RealEstate2/MiniPos/MiniPos GS.pdf

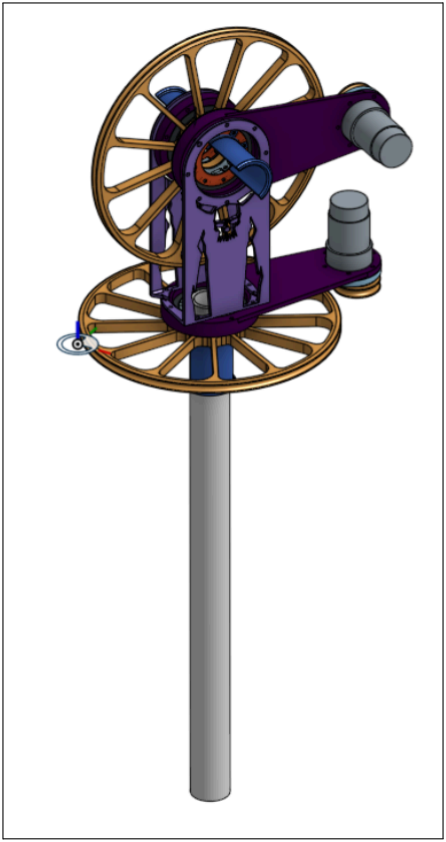
[picture p1: figure]

MiniPos Belt Driven Az-El Rotator with [6.667:1 = 20:3] Gear Ratio

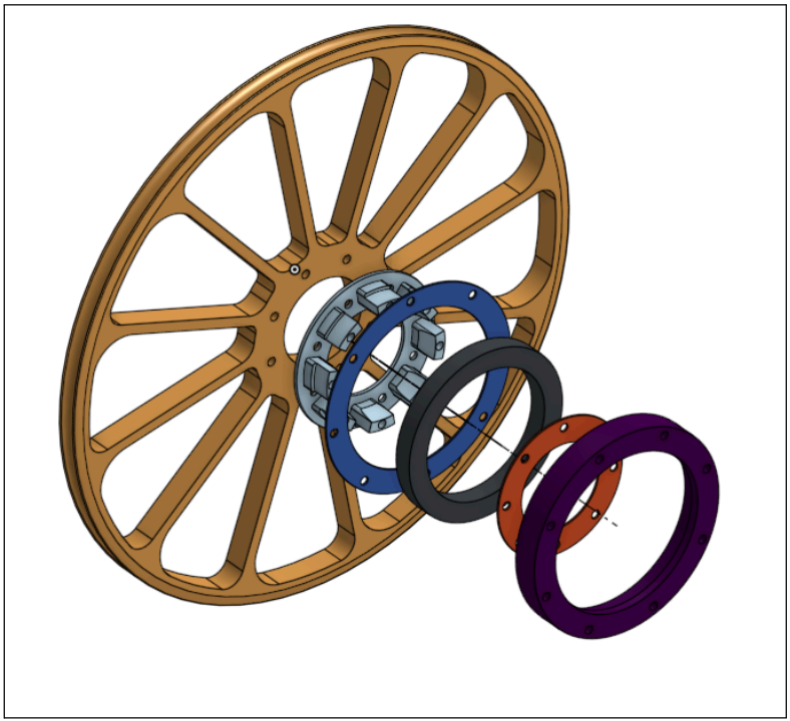
[picture p2: figure]

Bearing Assembly Part Order is as Such (Right To Left) Part Name: [8” Pulley Wheel - Bearing Hub -Bearing Retainer L - Bearing - Bearing Retainer S -Bearing Collar ]
Part #:[2- 8 - 11 - 7 - 10 - 9]

BOM

Part # | Name | Section | Quantity | Procurment | Cost ($) | 3D Print Mass (g)
1 | 1.2" Pully Wheel | Pully Drive | 2 | FDM | - | 5
2 | 8" Pully Wheel | Pully Drive | 2 | FDM | - | 78
3 | Polyeurethane Belt | Pully Drive | 2 | Amazon (https://www.amazon.com/Transmission-High-Performance-Urethane-Belting-Conveyor/dp/B083DS3YRG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) | 10
4 | Motor Carrier | Pully Drive | 2 | FDM | - | 50
5 | Motor Collar | Pully Drive | 2 | FDM | - | 7
6 | Geared Motor | Pully Drive | 2 | Digikey (https://www.digikey.com/en/products/detail/dfrobot/FIT0185/6588527?gclsrc=aw.ds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) | 33
7 | 50x65mm Bearing | Bearing Assy. | 3 | Amazon (https://www.amazon.com/uxcell-6810-2RS-Groove-Bearings-Double/dp/B082PXZLJT) | 20
8 | Bearing Hub | Bearing Assy. | 3 | FDM | - | 8
9 | Bearing Collar | Bearing Assy. | 1 | FDM | - | 17
10 | Bearing Retainer S | Bearing Assy. | 3 | FDM | - | 2
11 | Bearing Retainer L | Bearing Assy. | 3 | FDM | - | 2
12 | Upright Mounts | Structure | 1 | FDM | - | 35
13 | Shaft Coupler | Structure | 3 | FDM | - | 8
14 | 12V PSU | Power | 1 | Amazon (https://www.amazon.com/ALITOVE-Transformer-Switching-Converter-Security/dp/B078RTV9C4) | 20
15 | 12-5V Step Down | Power | 1 | Amazon (https://www.amazon.com/Converter-Regulator-Adapter-Reducer-Electronics/dp/B07Q5W1BG3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) | 12
16 | Motor Controller | Control | 1 | Amazon (https://www.amazon.com/dp/B0D11B8727/ref=twister_B0BJDKS21M?_encoding=UTF8&th=1) | 25
17 | ESP32 | Control | 1 | Digikey (https://www.digikey.com/en/products/detail/espressif-systems/ESP32-DEVKITC-32UE/12091813?gclsrc=aw.ds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) | 10

Approximate Cost TOtal ~$200 Approximate FDM Mass ~400g

Technical Specs and Drawings

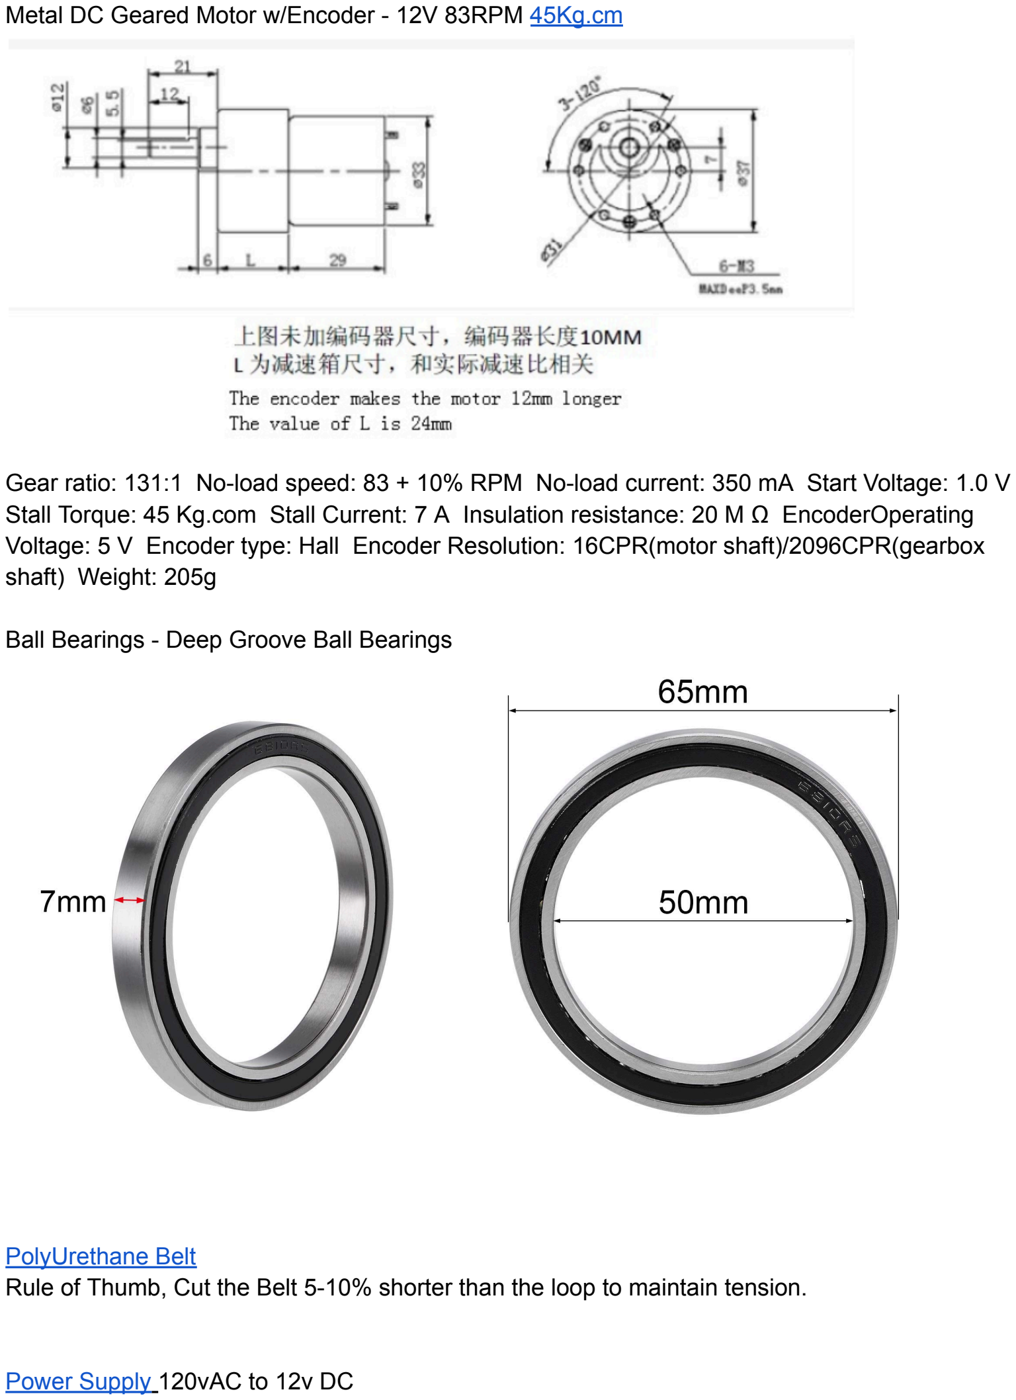
[picture p3: page 4]

Metal DC Geared Motor w/Encoder - 12V 83RPM 45Kg.cm

Gear ratio: 131:1 No-load speed: 83 + 10% RPM No-load current: 350 mA Start Voltage: 1.0 V Stall Torque: 45 Kg.com Stall Current: 7 A Insulation resistance: 20 M Ω EncoderOperating Voltage: 5 V Encoder type: Hall Encoder Resolution: 16CPR(motor shaft)/2096CPR(gearbox shaft) Weight: 205g

Ball Bearings - Deep Groove Ball Bearings

PolyUrethane Belt (https://www.amazon.com/Transmission-High-Performance-Urethane-Belting-Conveyor/dp/B083DS3YRG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)
Rule of Thumb, Cut the Belt 5-10% shorter than the loop to maintain tension.

Power Supply (https://www.amazon.com/ALITOVE-Transformer-Switching-Converter-Security/dp/B078RTV9C4) 120vAC to 12v DC

Step Down Converter 12v to 5v

Motor Controllers (https://www.amazon.com/dp/B0D11B8727/ref=twister_B0BJDKS21M?_encoding=UTF8&th=1)

ESP 32 (https://www.digikey.com/en/products/detail/espressif-systems/ESP32-DEVKITC-32UE/12091813?gclsrc=aw.ds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)

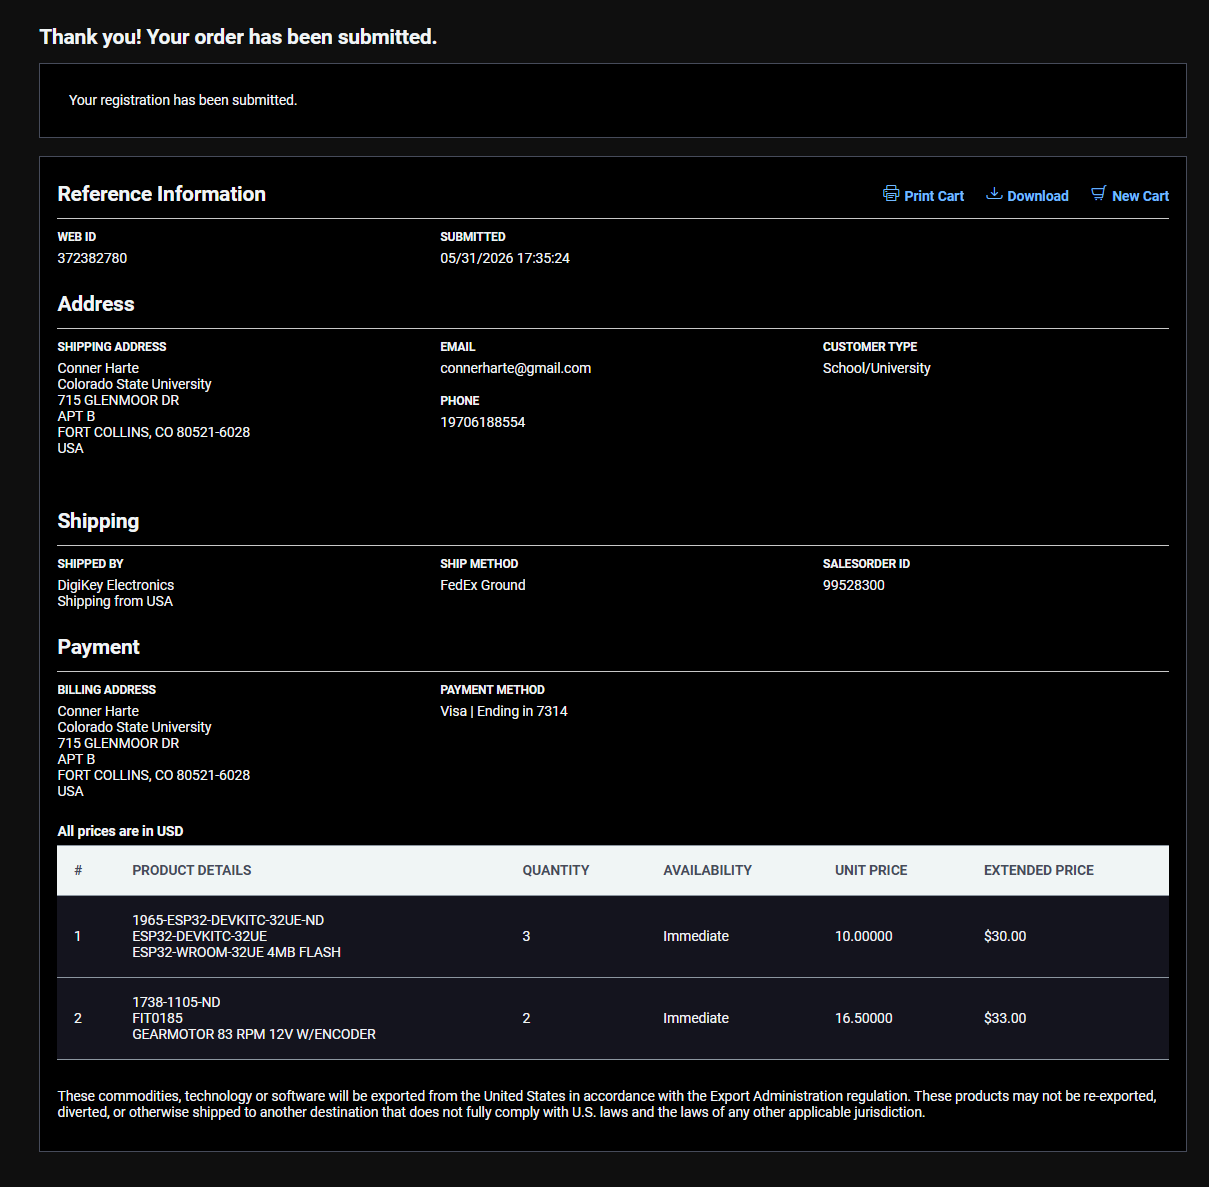
[picture p4: figure]
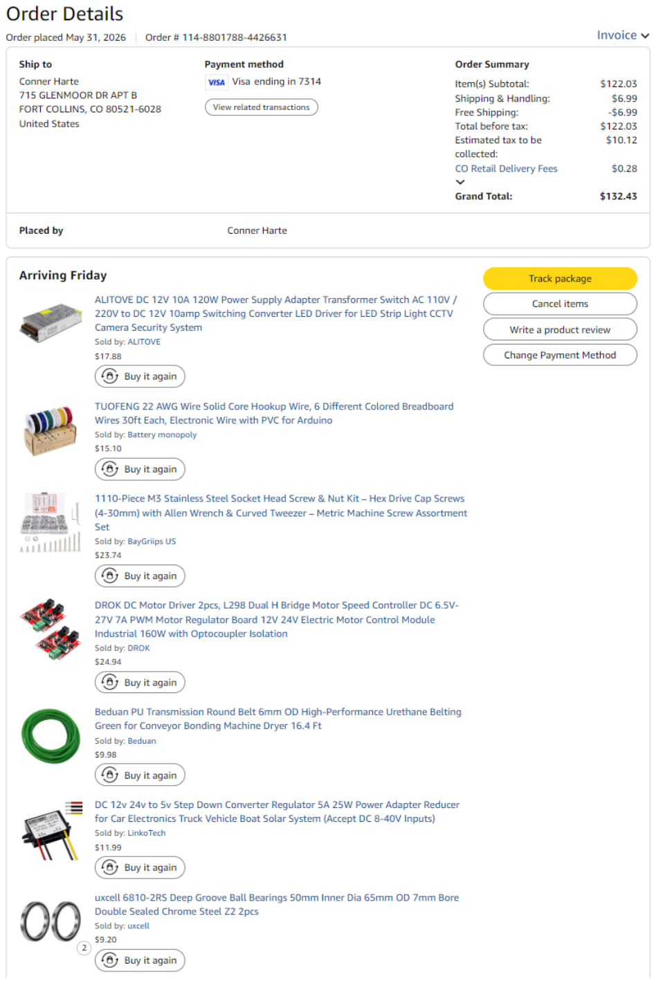
[picture p5: page 6]
