RealEstate2/MiniPos/circuit (4).png

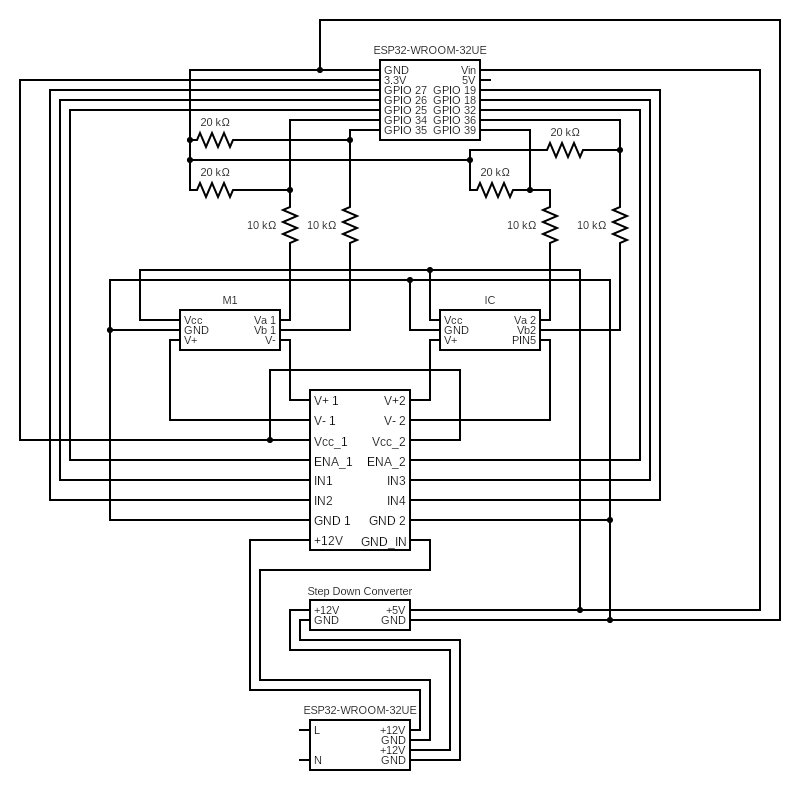
circuit (4).png
