RealEstate2/MiniPos/MiniPosV1.1/A_MotorCarrier.3mf

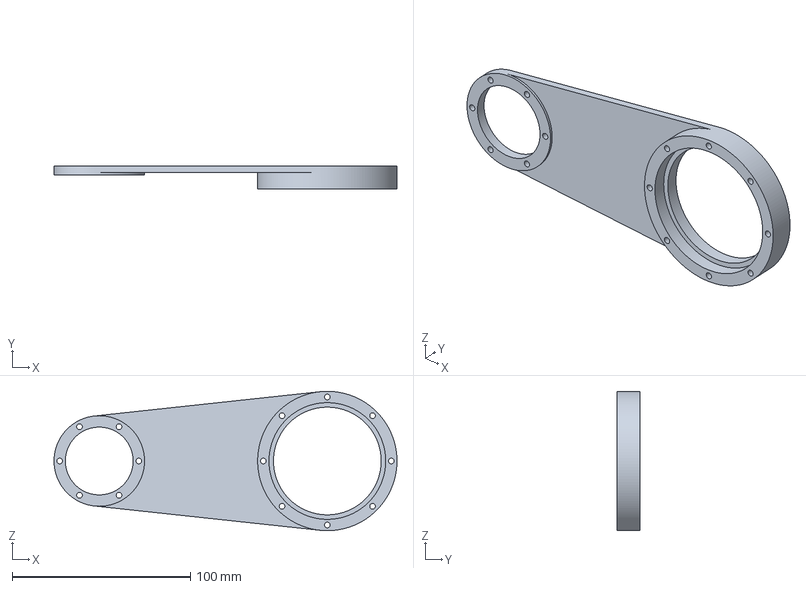
[picture p7: CAD file, 2026-06-04]
MiniPosV1.1/A_MotorCarrier.3mf
192.5 x 13.2 x 78.2 mm
