RealEstate2/MiniPos/MiniPosV1.1/B_SBearingRetainer.3mf

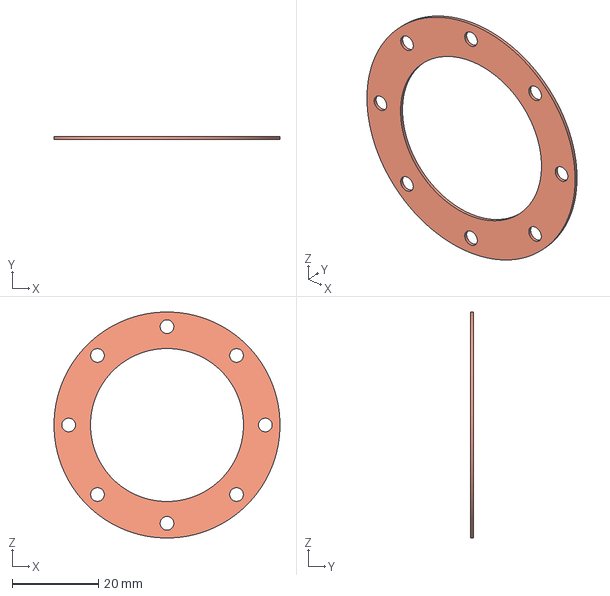
[picture p8: CAD file, 2026-06-04]
MiniPosV1.1/B_SBearingRetainer.3mf
52.5 x 0.635 x 52.5 mm
