RealEstate2/MiniPos/MiniPosV1.1/A_7.2PullyWheel.3mf

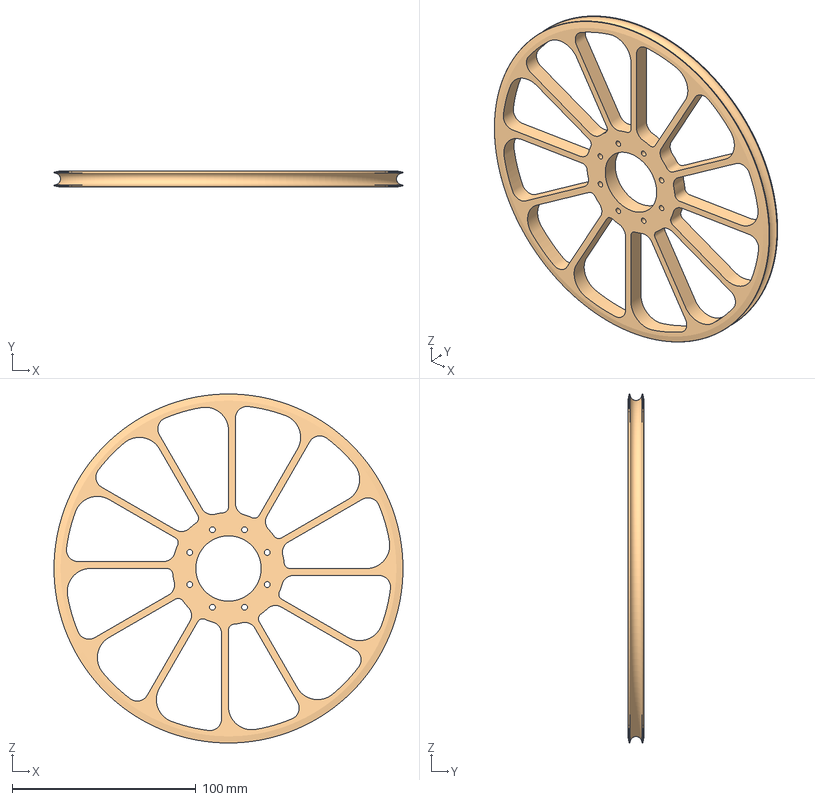
[picture p9: CAD file, 2026-06-04]
MiniPosV1.1/A_7.2PullyWheel.3mf
190.1 x 8.89 x 190.1 mm
