RealEstate2/MiniPos/MiniPosV1.1/C_UprightMountNoDesign.3mf

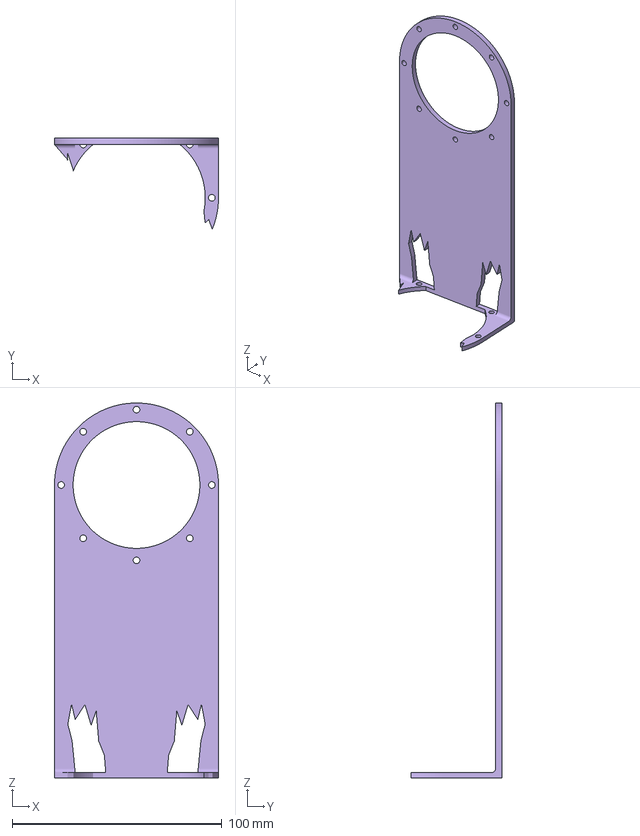
[picture p10: CAD file, 2026-06-04]
MiniPosV1.1/C_UprightMountNoDesign.3mf
78.2 x 43.5 x 178.8 mm
