RealEstate2/MiniPos/MiniPosV1.1/B_LBearingRetainer.3mf

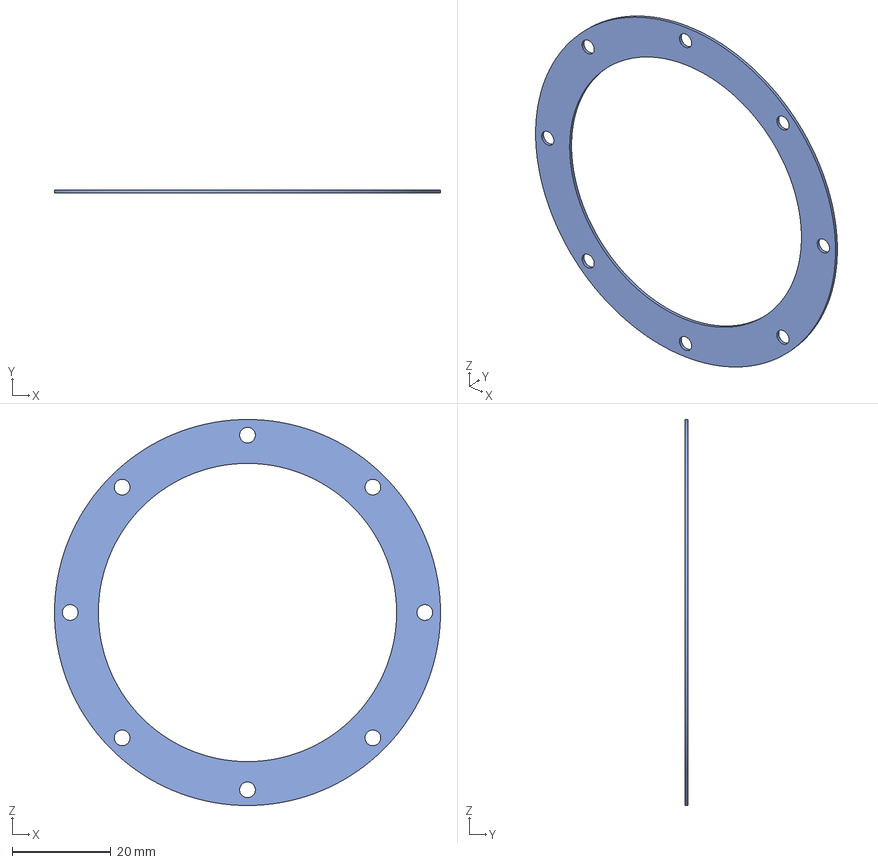
[picture p11: CAD file, 2026-06-04]
MiniPosV1.1/B_LBearingRetainer.3mf
78.2 x 0.635 x 78.2 mm
