RealEstate2/MiniPos/MiniPosV1.1/ A_1.2PullyWheel.3mf

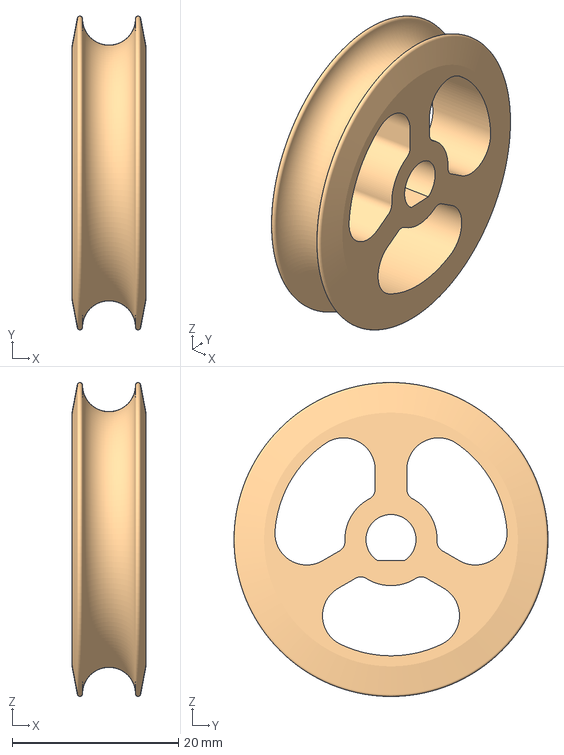
[picture p12: CAD file, 2026-06-04]
MiniPosV1.1/ A_1.2PullyWheel.3mf
8.89 x 37.7 x 37.7 mm
