RealEstate2/MiniPos/MiniPosV1.1/A_MotorCollar.3mf

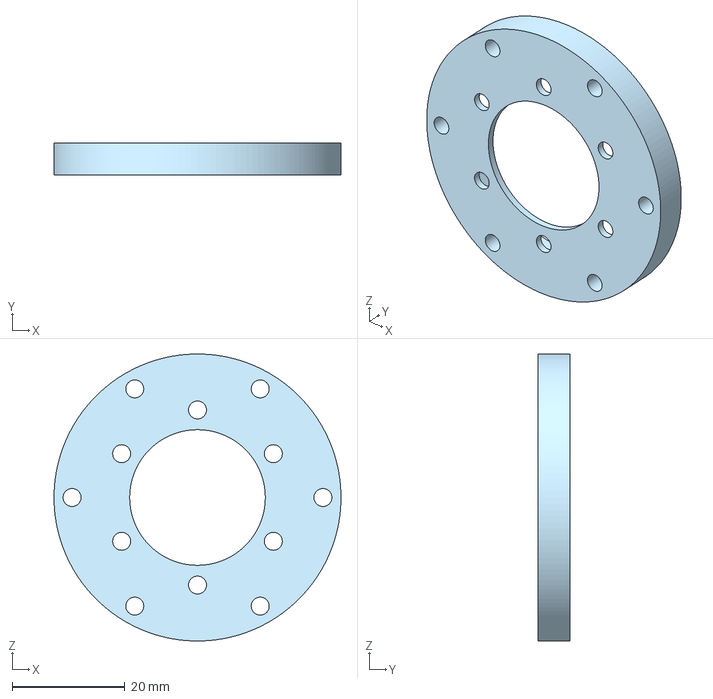
[picture p13: CAD file, 2026-06-04]
MiniPosV1.1/A_MotorCollar.3mf
50.8 x 5.71 x 50.8 mm
