RealEstate2/MiniPos/MiniPosV1.1/B_BearingCollar.3mf

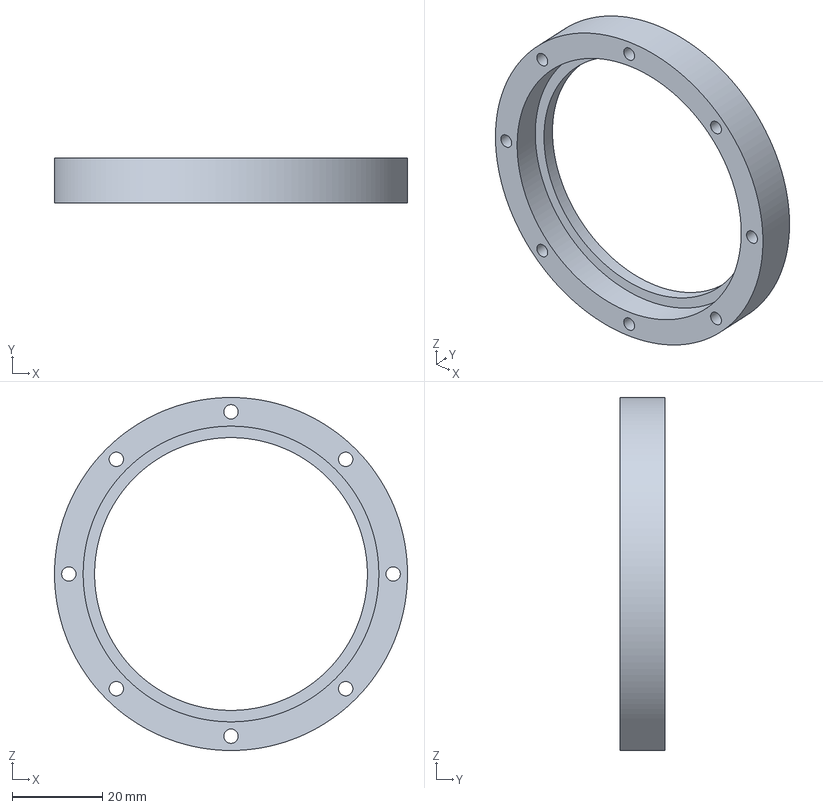
[picture p14: CAD file, 2026-06-04]
MiniPosV1.1/B_BearingCollar.3mf
78.2 x 9.97 x 78.2 mm
