RealEstate2/MiniPos/MiniPosV1.1/B_BearingHub.3mf

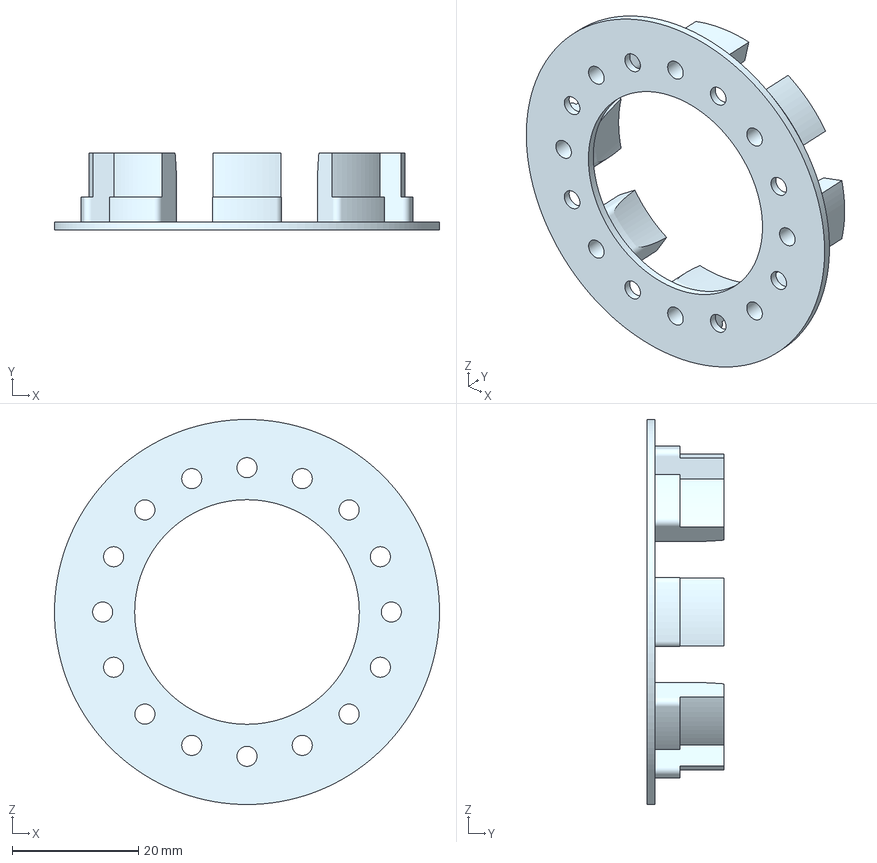
[picture p15: CAD file, 2026-06-04]
MiniPosV1.1/B_BearingHub.3mf
61.0 x 12.3 x 61.0 mm
