RealEstate2/MiniPos/MiniPosV1.1/C_ShaftCoupler.3mf

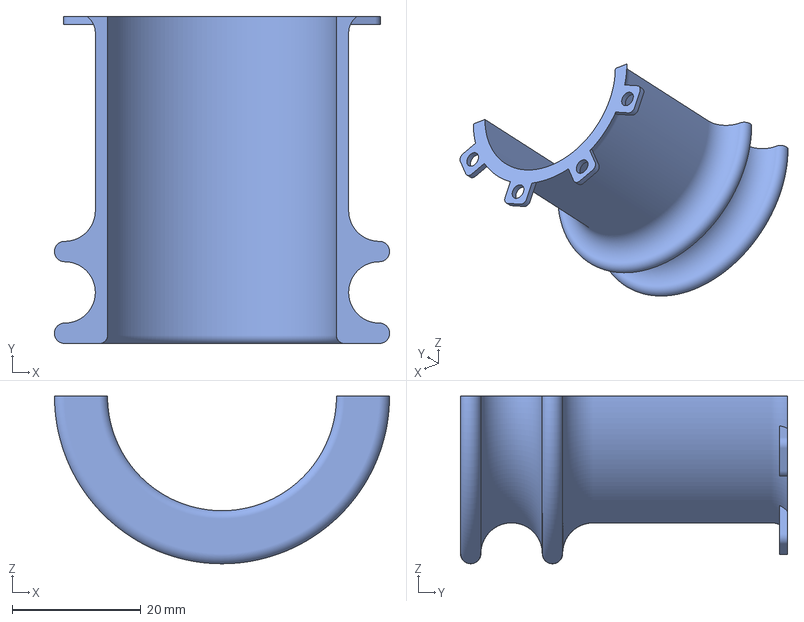
[picture p16: CAD file, 2026-06-04]
MiniPosV1.1/C_ShaftCoupler.3mf
52.1 x 50.8 x 26.0 mm
