RealEstate2/MiniPos/MiniPosV1/B_BearingCollar.3mf

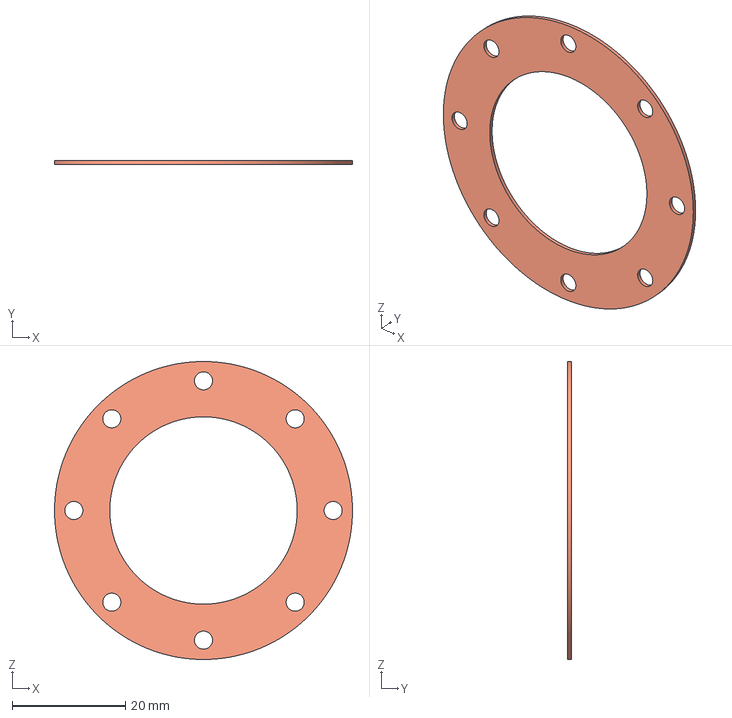
[picture p17: CAD file, 2026-06-01, an earlier design]
MiniPosV1/B_BearingCollar.3mf
52.5 x 0.635 x 52.5 mm
