RealEstate2/MiniPos/MiniPosV1/C_UprightMounts.3mf

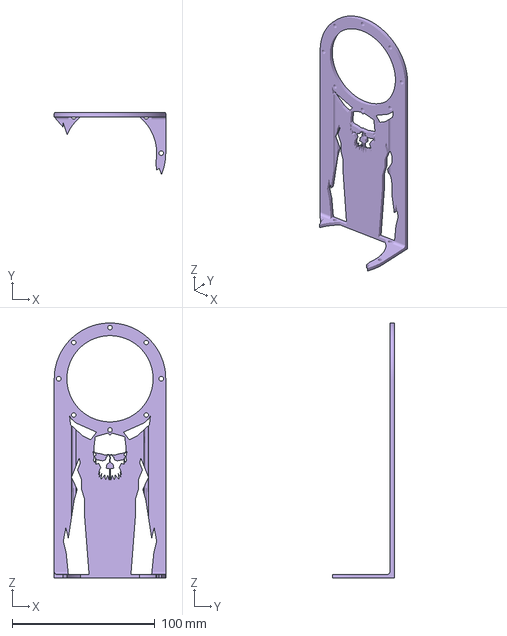
[picture p18: CAD file, 2026-06-01, an earlier design]
MiniPosV1/C_UprightMounts.3mf
78.2 x 43.5 x 178.8 mm
