RealEstate2/MiniPos/MiniPosV1/A_8PullyWheel.3mf

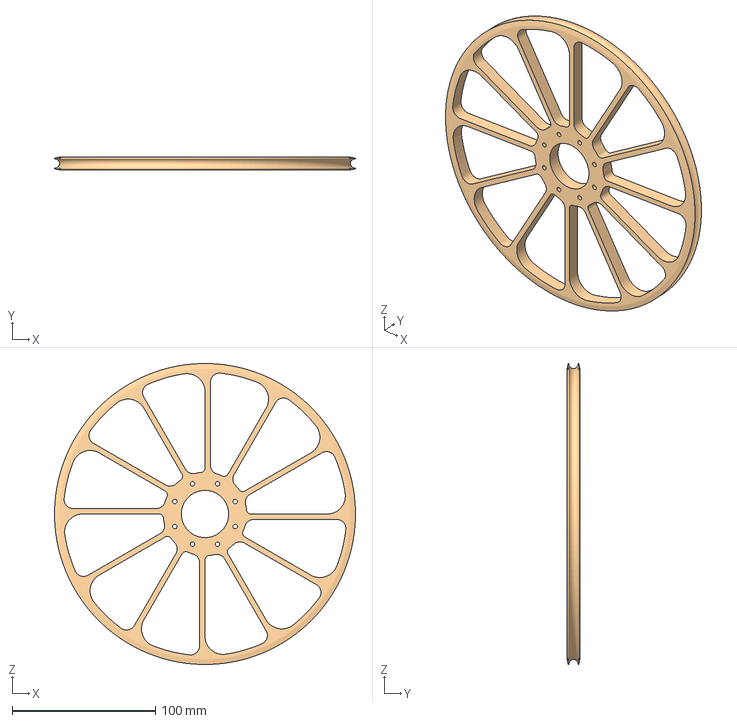
[picture p19: CAD file, 2026-06-01, an earlier design]
MiniPosV1/A_8PullyWheel.3mf
210.4 x 8.89 x 210.4 mm
