RealEstate2/MiniPos/MiniPosV1/C_ShaftCouplerS.3mf

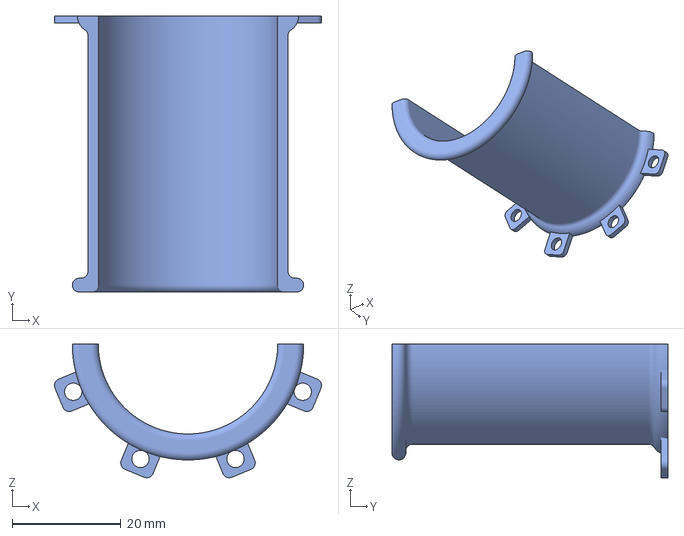
[picture p20: CAD file, 2026-06-01, an earlier design]
MiniPosV1/C_ShaftCouplerS.3mf
49.2 x 50.8 x 24.6 mm
