RealEstate2/MiniPos/(list of files, cad)

Other CAD files:
MiniPosV1/B_BearingRetainerL.3mf
MiniPosV1/A_1.2PullyWheel.3mf
MiniPosV1/A_MotorCarrier.3mf
MiniPosV1/B_BearingRetainerS.3mf
MiniPosV1/A_MotorCollar.3mf
MiniPosV1/B_BearingHub.3mf
