RealEstate2/MiniPos/(commit log)

2026-06-01 MiniPosV1 to Commit
    [A_1.2PullyWheel.3mf, A_8PullyWheel.3mf, A_MotorCarrier.3mf, A_MotorCollar.3mf, B_BearingCollar.3mf, B_BearingHub.3mf, B_BearingRetainerL.3mf, B_BearingRetainerS.3mf]
2026-06-04 Add CAD for version 1.1
2026-06-04 Added Cad for V1.1
    [A_1.2PullyWheel.3mf, A_7.2PullyWheel.3mf, A_MotorCarrier.3mf, A_MotorCollar.3mf, B_BearingCollar.3mf, B_BearingHub.3mf, B_LBearingRetainer.3mf, B_SBearingRetainer.3mf]
